andraszemes/one-lead-ecg/docs/kop-dokumentacia.pdf

Stredna priemyseln ´ | á skola elektrotechnick ˇ | a S. A. Jedlika v Nov ´ | ych Z ´ | amkoch ´

# Jednozvodovy elektrokardiograf ´

Praktická cas ˇ ť odbornej zlozky maturitnej sk ˇ | uśky ˇ
Nove Z´ amky, 2019 ´ | riesite ˇ

ľ: Andras Zemes ´
rocnˇ ík stˇ udia: ´ | stvrt ˇ | y´

konzultant: Mgr. Peter Hudec

Praktická cas ˇ ť odbornej zlozky maturitnej sk ˇ | uśky ˇ
a Zadanie ulohy pre komplexn ´ | u maturitn ´ | u sk ´ | uśku: ˇ
Meno a priezvisko: | Andras Zemes ´
Trieda: | 4. IT
Konzultant: | Mgr. Peter Hudec
Skolsk ˇ | y rok: ´ | 2018/2019
Odbor: | Informacnˇ e a sie ´ | ťove technol ´ | ogie ´
Nazov t ´ | emy: ´ | Jednozvodovy elektrokardiograf ´
Uloha: ´ | Zhotoviť prístroj, elektrokardiograf, na snímanie
a zachytenie elektrickych potenci ´ | alov srdca. ´
Prakticky charakter ´ | ulohy: ´ | Navrh plo ´ | snˇ eho spoja, programovanie ´
mikrokontrolera, vytvorenie grafickej aplik ´ | acie. ´
Andras Zemes, rie ´ | site ˇ

ľ

Mgr. Peter Hudec, interny konzultant ´

Zastupky ´ | na riadite ˇ

ľa skoly ˇ

V Novych Z ´ | amkoch d ´ | na 25.02.2019 ˇ

2

Ciastkov ˇ | é ulohy ´
1. Nastudovanie a spracovanie potrebnej te ˇ | orie ´
- Elektricky potenci ´ | al srdca ´
- Prehľad prístrojov EKG
- Signal a jeho spracovanie ´
2. Vytvorenie a konstrukcia pr ˇ | ístroja na meranie EKG
3. Vytvorenie elektronickej casti, pr ˇ | aca s mikrokontrol ´ | erom ´
4. Vytvorenie PC aplikacie na grafick ´ | e zobrazenie spracovan ´ | ych ´ | udajov ´
5. Webove rozhranie ku spracovan ´ | ym d ´ | atam ´

3

Cestn ˇ | e vyhl ´ | asenie ´
Ja, dolupodpísany Andr ´ | as Zemes, ´ | student 4. IT triedy Strednej priemyselnej ˇ | skoly S. A. Jedlika ˇ
v Novych Z ´ | amkoch, t ´ | ymto vyhlasujem, ´ | ze som t ˇ | uto pr ´ | acu vyhotovil s ´ | am, s pou ´ | zit ˇ ím uvedenej
literatury a pod ´

ľa rad m ´ ojho konzultanta. ˆ

Andras Zemes ´

4

## Podakovanie ˇ

Touto cestou by som sa chcel podakova ˇ | ť vsetk ˇ | ym, ktor ´ | í mi akymko ´

ľvek sposobom pomohli ˆ
a povzbudzovali ma pri vypracovaní mojej komplexnej maturitnej prace. Predov ´ | setk ˇ | ym v ´ | sak ˇ
patrí moja vdaka konzultantovi, Mgr. Petrovi Hudecovi, za jeho v ˇ | sestrann ˇ | u pomoc, za vedenie ´
a cenne pripomienky pri z ´ | avere ´ | cnom spracovan ˇ | í prace. ´

5

## Obsah

0 Uvod ´ | 7
1 Ciele | 8
2 Problematika a prehľad literatury | 9 ´
2.1 Elektrofyziologia srdca | | 9 ´
2.2 Akcnˇ y potenci ´ | al | | 10 ´
2.3.3 | Vydobytky modernej elektrokardiografie | | 12 ´
2.4 Umiestnenie elektrod | | 13 ´
2.5 Signal a jeho spracovanie | | 14 ´
2.5.1 | Sieťovy brum | | 14 ´
2.5.2 | Potlacenie driftu | | 14 ˇ
2.5.3 | Myopotencialy | | 14 ´
2.5.4 | Cˇíslicove filtre | | 15 ´
3 Metodika prace | 16 ´
3.1 Navrh a kon ´ | strukcia hardv ˇ | eru | | 16 ´
3.1.1 | Zosilnovac ˇ | í obvod na vyvojovej doske | | 16 ´
3.1.2 | Spajkovan ´ | y obvod | | 17 ´
3.1.3 | Finalny obvod a roz ´ | sirovacie moduly | | 18 ˇ
3.1.4 | Konstrukcia zariadenia | | 20 ˇ
3.2 Tvorba softveru | | 21 ´
3.2.1 | Hardverov ´ | e programovanie | | 21 ´
3.2.2 | Graficke pou ´ | zˇívateľske rozhranie (GUI) | | 21 ´
4 Vysledky a diskusia | 23 ´
5 Zavery pr ´ | ace | 27 ´
6 Zoznam pouzitej literat ˇ | ury | 28 ´
7 Prílohy | 29

6

## 0 Uvod ´

Ludsk ˇ | e telo je z ´ | azra ´ | cnˇ y´ ziv ˇ y organizmus, ktor ´ | y sa spr ´ | ava pod ´
ľa zakonitost ´ | í prírody a biologie. ´
Dnes znama podoba Homo sapiens je v ´ | ysledkom prirodzen ´ | eho evolu ´ | cnˇ eho v ´ | yberu, ktor ´ | ym´
prechadza u ´ | z mili ˇ | ony rokov. V ´ | daka nemu s ˇ | u na ´ | se org ˇ | any vyspel ´ | e a odoln ´ | e, dokonale sl ´ | uźia ˇ
prezitiu. Ich rola a presn ˇ | y sp ´ | osob fungovania v ˆ | sak dlho zost ˇ | avali z ´ | ahadou pred lek ´ | armi a ved- ´
cami v minulosti. Revolucnˇ e objavy a v ´ | ydobytky v medic ´ | íne viedli k podrobnemu zmapovaniu ´
a poznaniu ľudskeho tela, i ke ´ | d mnoho fenom ˇ | enov je doposia ´
| | | | | | | ľ nevysvetlenych. Choroby sa stali ´
liecite ˇ

ľnymi a pred ´

´lzil sa predpokladan ˇ | y vek do ´ | zitia. ˇ
V modernej dobe sa vyrazne zmenil ´ | stˇ yl, ak ´ | ym´ | zijeme. Jeho d ˇ | osledky nes ˆ | u na ´ | se tel ˇ | a, ktor ´ | é
neboli stavane na ru ´ | snˇ y, upon ´ | ah´
ľany sp ´ | osob ˆ | zivota a na zvl ˇ | adanie ka ´ | zdodenn ˇ | eho stresu. Ne- ´
spravna ´ | zivotospr ˇ | ava, zl ´ | e n ´ avyky a degrad ´ | acia ´ | zivotn ˇ | eho prostredia maj ´ | u z ´ aporn ´ | y vplyv na ´
zdravotny stav obyvate ´
ľstva a prispievaju k ´ | sˇíreniu civilizacnˇ ych ochoren ´ | í. Jedna sa o degen- ´
eratívne ochorenia, ktore patria medzi najp ´ | al´ civej ˇ | sie glob ˇ | alne zdravotn ´ | ícke problemy. ´
V rebríckoch naj ˇ | castej ˇ | sˇích prícin smrti sa ˇ | casto vyskytuj ˇ | u na prv ´ | ych prie ´ | ckach. ˇ
Skodliv ˇ | e zvyklosti ako nezdrav ´ | e stravovanie, nedostatok fyzickej aktivity, faj ´ | cenie a nad- ˇ
merna konzum ´ | acia alkoholu sa odzrkad ´
ľuju aj na srdci a obehovej s ´ | ustave. Tieto a mnoho ´
dal ˇ sˇích faktorov zvysuj ˇ u riziko srdcovocievnych ochoren ´ | í vratane k ´ | ornatenia tepien, infarktu ˆ
myokardu, vysokeho krvn ´ | eho tlaku, at ´ | d. ˇ Ludia si ve ˇ | ľakrat ani neuvedomuj ´ | u, ´ ze sa u nich vyv ˇ | íja
takato choroba, alebo si to uvedomia neskoro. ´
Riesenie m ˇ | oẑe poskytn ˇ | u´ť bioinformatika a biomedicínske inzinierstvo. S ˇ | u to vedn ´ | e dis- ´
ciplíny, ktore sa zaoberaj ´ | u zhroma ´ | zďovan ˇ | ím a vyhodnocovaním biologickych d ´ | at a kon ´ | strukciou ˇ
klinickych zariaden ´ | í. Vo veľkej miere uľahcuj ˇ u pr ´ | acu lek ´ | arom vo v ´ | casnom rozpoznan ˇ | í a liecbe ˇ
zdravotnych probl ´ | emov. Klasick ´ | ym pr ´ | íkladom biomedicínskeho prístroja je elektrokardiograf,
alebo skratkou EKG.
V roku 1903 Willem Einthoven zostrojil prvy funk ´ | cnˇ y elektrokardiograf. Pou ´ | zil strunov ˇ | y´
galvanometer na snímanie elektrickych potenci ´ | alov z kon ´ | cat ˇ ín pacienta. Jeho vynalez sa stal ´
zakladn ´ | ym kame ´ | nom elektrokardiografie, za ktor ˇ | y nesk ´ | or z ˆ | ískal Nobelovu cenu za fyziologiu ´
alebo medicínu. Vdaka Einthovenovi lek ˇ | ari dostali prv ´ | ykr ´ at v hist ´ | orii mo ´ | znos ˇ | ť nahliadnuť
hlboko do srdca a odhaliť skryte defekty prevodov ´ | eho syst ´ | emu. ´
Myslím si, ze najv ˇ | a¨cšˇím nepriateľom ľudstva je neinformovanosť. Pokiaľ chceme predísť
chorobam a ´ | ziˇ ť zdravy, plnohodnotn ´ | y´ zivot, mus ˇ | íme poznať moznˇ e n´ asledky rizikov ´ | eho spr ´ | avania. ´
Zamerom tejto pr ´ | ace je ´ | sˇíriť povedomie o dole ˆ zitosti starostlivosti o zdravie a preuk ˇ | aza ´ ť, ze po- ˇ
zorovanie vnutrotelov ´ | ych javov nemus ´ | í byť tak zlozit ˇ e ako sa na prv ´ | y poh ´
| | | | | | | | ľad zda.´

7

## 1 Ciele

Kľućˇ uspe ´ | snˇ eho elektrotechnick ´ | eho projektu spo ´ | cˇíva v dokonalej spolupraci jeho elektronick ´ | ych ´
a informacnˇ ych zlo ´ | ziek. Z ˇ | amerom tejto pr ´ | ace je pouk ´ | aza ´ ť na to, ze aj pomerne jednoduch ˇ | ymi ´
komponentmi sa daju vyrie ´ | siˇ ť komplexne probl ´ | emy. ´
Dole ˆ zit ˇ e aspekty v ´ | yslednej pr ´ | ace s ´ | u univerz ´ | alnos ´ | ť, portabilita a intuitívny dizajn. Prístroj by
mal dokaza ´ ť pouziˇ ť kazdˇ y bez ´ | speci ˇ | alneho vybavenia a bez podrobnej znalosti jeho fungovania. ´
Riesenie m ˇ | a by ´ | ť taktiez prenosn ˇ | e, aby bolo neobmedzene vyu ´ | zite ˇ

ľne.´
Pri navrhu plo ´ | snˇ eho spoja sa muselo prihliada ´ | ť i na bezpecnos ˇ | ť pri pouzit ˇ í prístroja. Elek-
trokardiograf sleduje pulz snímaním elektrickych potenci ´ | alov srdca z povrchu tela elektr ´ | odami. ´
Napajan ´ | ím obvodu bateriami a ochranou mal ´ | ym nap ´ | at¨ ím sa zabranilo v ´ | yskytu ne ´ | cakan ˇ | ych a ´
potencialne rizikov ´ | ych situ ´ | aci ´ í.
Pomocou jednozvodoveho EKG vieme ur ´ | ciˇ ť pulz, srdcovy rytmus, ba aj odhali ´ | ť prítomnosť
srdovych arytmi ´ | í a fibrilacie predsien ´ | í. Projekt moẑe taktie ˇ | z sl ˇ uźiˇ ť ako pomocka pri v ˆ | yú cbe elek- ˇ
troniky, programovania ci informatiky. Zn ˇ | azor ´ | nuje fungovanie sign ˇ | alov ´ | ych filtrov, opera ´ | cnˇ ych ´
zosilnova ˇ | cov, mikrokontrol ˇ | erov a grafick ´ | ych po ´ | cˇítacov ˇ ych aplik ´ | aci ´ í.

8

## 2 Problematika a prehľad literatury ´

Dovoľujem si vas obozn ´ | ami ´ | ť s teoretickymi v ´ | ychodiskami a informova ´ | ť o zakladn ´ | ych poz- ´
natkoch, ktore sa t ´ | ykaj ´ | u nastolenej problematiky. Princ ´ | ípy elektrokardiografie tvoria kmen tejto ˇ
prace a s ´ | u jej neoddelite ´

ľnou sućas ˇ ťou.

### 2.1 Elektrofyziologia srdca ´

Zakladom vn ´ | utorn ´ | eho fungovania srdca je jeho elektrick ´ | a aktivita. Srdce je jedine ´ | cnˇ y org ´ | an´
z hľadiska, ze jeho elektrick ˇ | á cinnos ˇ | ť nie je nervovo zalozen ˇ a. Vykon ´ | avaj ´ | u ju ´ | specializovan ˇ | é
vodive svalov ´ | e bunky. Zv ´ | azky tak ¨ | ychto buniek podmie ´ | nuj ˇ ú cerpaciu schopnos ˇ | ť srdca.
Svalove kontrakcie s ´ | u riaden ´ | e elektrick ´ | ymi impulzmi, ktor ´ | e sa ´ | sˇíria po prevodovom systeme ´
a pracovnom myokarde. Menia elektricke potenci ´ | aly na r ´ | oznych bodoch poko ˆ | zky pribli ˇ | zne ˇ
o tisícinu voltu (1 mV). Tato elektrick ´ | a aktivita skr ´ | yva v sebe neuverite ´
ľne mno ´ | zstvo inform ˇ | aci ´ í,
prostredníctvom ktorych z ´ | ískame nah´
ľad do fungovania tohto zazra ´ | cnˇ eho org ´ | anu. ´
Zdrojom tychto impulzov je sinoatri ´ | alny (SA) uzol, ktor ´ | y sa nach ´ | adza v stene hornej ´ | casti ˇ
pravej predsiene. Udava frekvenciu kontrakci ´ | í myokardu (srdcoveho svalstva), ktor ´ | a je nomin ´ | alne ´
70 tepov za minutu. ´
Signaly sa ´ | dalej ˇ | sˇíria vodivymi dr ´ | ahami predsien ´ | í a stimuluju svalov ´ | e kontrakcie. Pokra ´ | cuj ˇ ú
po srdcovej priehradke, septe, ktora odde ´

ľuje dve polovice srdca. Blízko bodu spojenia styroch ˇ
dutín srdca sa nachadza zhluk ´ | speci ˇ | alnych buniek - atrioventrikul ´ | arny (AV) uzol. Uzol AV ´
postup vzruchov mierne inhibuje a nasledne ich vysiela do Hisovho zv ´ | azku. ¨
Hisov zvazok sa del ¨ | í na dve vetvy, tzv. Tawarove ramienka. Obidve vetvy vedu do siete ´
Purkynov ˇ ych vl ´ | aken, ktor ´ | e aktivuj ´ | u pracovn ´ | y myokard. ´


Obrazok 1: Prevodov ´ | y syst ´ | em srdca ´

9

2.2 Akcnˇ y potenci ´ | al´
Ako vyraba a pren ´ | aśa srdcov ˇ | e tkanivo elektrick ´ | e impulzy? Aby sme si priebeh tohto deja mohli ´
vysvetliť, musíme sa preniesť az na ˇ | urove ´ | n at ˇ omov. ´
Atom je neutr ´ | alny, ´ | ak ma rovnak ´ | y po ´ | cet prot ˇ | onov (kladne nabit ´ | ych ´ | cast ˇ | íc) a elektronov ´
(zaporne nabit ´ | ych ´ | cast ˇ | íc).
Iony vznikaj ´ | ú z elektricky neutralnych at ´ | omov pridan ´ | ím resp. ubraním elektronov. ´
V pokoji je srdcova bunka v ´ | polarizovanom stave:
- mimobunkovy priestor je elektricky pozit ´ | ívny pre vysoku koncentr ´ | aciu kladn ´ | ych i ´ | onov ´
sodíka a vapnika ´
- vnutrobunkov ´ | y priestor je oproti vonkaj ´ | sej strane negat ˇ | ívny
- rozdiel potencialov je -90mV ´
Ked pokojov ˇ | y membr ´ | anov ´ | y potenci ´ | al dosiahne ur ´ | cit ˇ u prahov ´ | u hodnotu (cca. 15 mV), tzv. ´
akcnˇ y potenci ´ | al´ , tento pokojovy stav sa n ´ | ahle zmen ´ | í. V membrane bunky sa otvoria prieduchy ´
a kladne nabite i ´ ony pr ´ | udia sp ´ | a¨ť do bunky. Tato n ´ | ahla strata polariz ´ | acie sa vol ´ | a depolariz ´ | acia ´
a vznika pri nej elektrick ´ | y pr ´ | ud. ´
Po depolarizacii nast ´ | ava protikladn ´ | y dej, repolariz ´ | acia, ke ´ | d sa i ˇ | ony znovu pre ´ | cerp ˇ | avaj ´ | u von ´
mimo membranu. Depolariza ´ | cnˇ a vlna vyvol ´ | avan ´ | a uzlom SA sa ´ | sˇíri po prevodovom systeme ´
srdca a uvadza svaly do pohybu. Proces, ktor ´ | y za ´ | cal pumpovan ˇ | ím ionov takto kon ´ | cˇí pumpo-
vaním krvi.

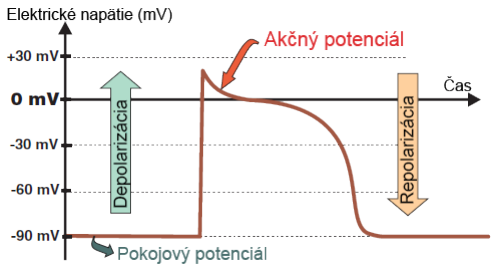
[picture p19: figure]

Obrazok 2: Ak ´ | cnˇ y potenci ´ | al v grafickom vyobrazen ´ | í

10

### 2.3 Prehľad prístrojov EKG

2.3.1 Druhy funkcnˇ ych vy ´ | setren ˇ | í
Elektrokardiografia je jednym zo z ´ | akladn ´ | ych lek ´ | arskych vy ´ | setren ˇ | í. Najcastej ˇ | sie sa vyu ˇ | zˇíva
v nudzov ´ | ych situ ´ | aci ´ ach pri podozren ´ | í na srdcovy infarkt, na zistenie poruchy s ´ | uvisiacej s kar- ´
diovaskularnym syst ´ | emom alebo ako prevent ´ | ívne vysetrenie so z ˇ | amerom odhali ´ | ť moznˇ y srdcov ´ | y´
defekt.
Vysetrenie EKG je neinvaz ˇ | ívne a nevyzaduje ˇ | ziadnu ˇ | speci ˇ | alnu pr ´ | ípravu. Pri klasickom EKG
sa elektrody pripevnia na hrudn ´ | ík, zap´ astia a ¨ | clenky pacienta. Elektrick ˇ | e sign ´ | aly zachyten ´ | é
z povrchu tela, ktore s ´ u spravidla ve ´
ľmi slabe, v r ´ | adoch milivoltov, pr ´ | ístroj zosilní a zaznamena.´
Nasledne ich lek ´ | ar vyhodnot ´ | í.
Existuje niekoľko roznych druhov vy ˆ | setrn ˇ | í:
Standardn ˇ | e 12-zvodov ´ | e EKG ´
Je najcastej ˇ | sie pou ˇ | zˇívany zo v ´ | setk ˇ | ych typov EKG. Pozost ´ | ava zo 6 kon ´ | catinov ˇ | ych zvodov a 6 ´
hrudnych zvodov. Ka ´ | zdˇ y zvod je samostatne zapisovan ´ | y na priebe ´ | zne sa posunuj ˇ | uci ´ | speci ˇ | alny ´
zaznamov ´ | y papier, pr ´ | ípadne zobrazuje hodnoty na monitore.

Za´ťazov ˇ e EKG (ergometria) ´

Ukaźe spr ˇ | avanie srdca a obehov ´ | eho syst ´ | emu pri n ´ | amahovej aktivite. Na simul ´ | aciu sa v ´ | a¨cšinou ˇ
pouzˇíva stacionarny bicykel alebo be ´ | zeck ˇ | y p ´ as. Monitoruje sa z ´ | aznam EKG v s ´ | uvislosti ´
s krvnym tlakom. Na z ´ | azname sa p ´ | atra po zmen ´ | ach, ktor ´ | e na EKG urobenom v pokoji nie ´
su vidite ´

ľne.´

Dynamicke EKG ´

Umozňuje sledova ˇ | ť srdcovú cinnos ˇ | ť pri beznˇ ych aktivit ´ | ach po ´ | cas 12-48 hod ˇ | ín. Zvyśen ˇ ím doby
monitorovania sa zvysuje pravdepodobnos ˇ | ť nalezu nepravidelnost ´ | í rytmu alebo namahov ´ | ych ´
ischemi ´ | í myokardu v zazname. ´

Tlakovy Holter ´

Ambulantne 24-hodinov ´ | e sledovanie krvn ´ | eho tlaku je jednoduch ´ | e vy ´ | setrenie ˇ | casto indikovan ˇ | é
pri diagnostikovaní hypertenzie. Sníma sa tlak krvi v domacom prostred ´ | í pri kazdodenn ˇ | ych ´
cinnostiach pomocou nafukovacej man ˇ | zety. ˇ
EKG urcuje z ˇ | akladn ´ | e fyziologick ´ | e hodnoty ako s ´ | u frekvencia srdcovej ´ | cinnosti, rytmus, elek- ˇ
tricka os srdca, prevodov ´ | é casy a morfol ˇ | ogia segmentov EKG krivky. Na z ´ | aklade t ´ | ychto para- ´
metrov moẑe by ˇ | ť stanovena diagn ´ | oza a rozpoznan ´ | a porucha srdcov ´ | eho rytmu (arytmia), porucha ´
prevodu elektrickych vzruchov, ischemick ´ | a choroba srdca a in ´ | e patologick ´ | e zmeny v myokarde. ´

11

2.3.2 Casti klasick ˇ | eho pr ´ | ístroja EKG
Tepelna tla ´ | cov ˇ a hlava ´
Kreslí EKG krivku generovaním tepla.

Termopapier
Prichadza do kontaktu s tla ´ | covou hlavou. Na mieste dotyku sa farba papiera men ˇ | í na ciernu, ˇ
takto vznika krivka EKG. Papier je tie ´ | z citliv ˇ | y na tlak. ´

Elektrody ´
Elektrody s ´ | u vyroben ´ | e z vodiv ´ | eho materi ´ | alu, ktor ´ | y dok ´ | aźe zachyti ˇ | ť elektricke impulzy zo srdca. ´
Signaly odosielaj ´ | u na spracovanie do meracieho pr ´ | ístroja cez pripojene k ´ able. ´
Zosilnova ˇ | cˇ
Zosilnova ˇ | c je zariadenie, ktor ˇ | e sa nach ´ | adza v elektrokardiografe a zvy ´ | suje amplit ˇ | udu elek- ´
trickeho sign ´ | alu. Sign ´ | aly prich ´ | adzaj ´ | uce zo srdca s ´ | u relat ´ | ívne slabe (0,0001V a ´ | z 0,003V) a je ˇ
potrebne ich zosilni ´ | ť.

Galvanometer
Premiena pr ˇ | ud na mechanick ´ | y pohyb. ´

Sada EKG kablov ´
Sluźia na spojenie zvy ˇ | cajne desiatich elektr ˇ | od s hlavnou jednotkou pr ´ | ístroja EKG. Takato kon- ´
figuracia umo ´ | zňuje monitorova ˇ | ť srdce z 12 ,,pohľadov”.

### 2.3.3 Vydobytky modernej elektrokardiografie ´

Moderne pr ´ | ístroje EKG disponuju zabudovan ´ | ymi mikroprocesormi, ktor ´ | e ich riadia a roz ´ | siruj ˇ | ú
ich diagnosticke schopnosti. V ´ | daka sofistikovan ˇ | ym matematick ´ | ym algoritmom a modelom s ´ | ú
schopne previes ´ | ť zlozit ˇ u anal ´ | yzu sign ´ | alu a automaticky ho vyhodnoti ´ | ť. Su kompaktn ´ | e, prenosn ´ | é
a vhodne i na monitorovanie mimo zdravotn ´ | íckeho zariadenia.
Prepojiteľnosť s pocˇítacom je v dne ˇ | snej dobe takmer samozrejmos ˇ | ťou, niektore dokonca ko- ´
munikuju bezdr ´ | otovo a aj na dia ˆ
ľku. Digitalizacia ´ | udajov m ´ | oẑe by ˇ | ť vyhodn ´ | a napr ´ | íklad z hľadiska
archivacie alebo v pr ´ | ípade potreby zdieľať zaznam so ´ | specialistom. ˇ
Kardiologicky monitor je ´ | cast ˇ | ym roz ´ | sˇírením zariadenia EKG a umozňuje dlhodobo sledova ˇ | ť
srdcovu aktivitu pacienta. ´ | Udaje zobrazuje v re ´ | alnom ´ | case a pon ˇ | uka n ´ | ah´

ľad kriviek este pred ich ˇ zapisom na papier. ´

12

### 2.4 Umiestnenie elektrod´

Tri koncatinov ˇ | e elektr ´ | ody (prav ´ | a ruka, ´

ľava ruka, ´

ľava noha) vytv ´ | araj ´ | u Einthovenov trojuholn ´ | ík.
Vzniknu 3 ´ | bipolarne zvody ´ | reprezentovane stranami trojuholn ´ | íka. Kazdˇ y zvod pozost ´ | ava ´
z dvoch elektrod, z pozit ´ | ívneho a z negatívneho. Pozitívny a negatívny pol spolu tvoria elek- ´
tricky vektor, ktor ´ | y sa premieta na papier. ´
Zvod I: | VI = φL −φR

Zvod II: VII = φF −φR

Zvod III: VIII = φF −φL

, kde:
VI = napatie zvodu I ¨
VII = napatie zvodu II ¨
VIII = napatie zvodu III ¨
φL = potencial na ´

ľavej ruke
φR = potencial na pravej ruke ´
φF = potencial na ´

ľavej nohe

Podľa Kirchhoffovho zakona plat ´ | í, ze ve ˇ
ľkosť potencialov (amplit ´ | ud na EKG z ´ | azname) vo zvode ´
VII je sumou potencialov v zvodoch ´ | | VI a VIII:
VI +VIII = VII , z coho vypl ˇ | yva, ´ | ze iba dva z troch zvodov s ˇ | u nez ´ | avisl ´ | e.´
Einthoven definoval rozdiely potencialov medzi troma p ´ | armi horeuveden ´ | ych bodov ako z ´ | akladn ´ | é
koncatinov ˇ | e zvody v elektrokardiografii. ´


Obrazok 3: Einthovenove kon ´ | catinov ˇ | e zvody a Einthovenov trojuholn ´ | ík

13

### 2.5 Signal a jeho spracovanie ´

Po uspe ´ | snom zmeran ˇ | í a zosilnení signalu ´ | cel ˇ íme zlozitej prek ˇ | aźke v snahe zachyti ˇ | ť srdcovy´
rytmus. Signal je s ´ | íce zosilneny, ale na ´ | dalej obsahuje mnoho ne ˇ | ziaducich elementov vplyvom ˇ
rusivˇ ych faktorov z okolia. V ´ | ysledkom je skreslen ´ | y biosign ´ | al, ktor ´ | y je v tejto f ´ | aze nepou ´ | zite ˇ

ľny.´
Nepresnosti v meraniach odborne nazyvame ´ | artefakty. | Artefakty sa moẑu prejavova ˇ | ť
v mensej ˇ | ci v ˇ | a¨cšej miere v z ˇ | avislosti od nedokonalost ´ | í v priebehu vedenia signalu z pacienta ´
do aparatury (pr ´ | ístroja). V elektrokardiografii rozoznavame tri z ´ | akladn ´ | e druhy artefaktov: ´
- sieťovy brum ´
- kolísanie nulovej línie (drift)
- myopotencialy ´
V minimalizacii ne ´ | ziaduceho ˇ | sumu n ˇ | am napom ´ | aha s ´ | ubor ´ | specializovan ˇ | ych hardv ´ | erov ´ | ych ´
i digitalnych filtrov. ´

### 2.5.1 Sieťovy brum ´

Prvym krokom spracovania sign ´ | alu je z ´ | akladn ´ | a hardv ´ | erov ´ | a filtr ´ | acia. Elektromagnetick ´ | a inter- ´
ferencia (EMI) vznika p ´ osoben ˆ | ím elektromagnetickeho po ´

ľa z elektrickej siete. Pri tomto jave
dochadza k vzniku indukovan ´ | eho nap ´ | atia (Ui) a indukovan ¨ | eho pr ´ | udu na vodi ´ | ci. ˇ Sum op ˇ | ísaneho ´
druhu moẑeme charakterizova ˇ | ť pri frekvencii 50 Hz sínusoveho ru ´ | senia. Na potla ˇ | cenie sie ˇ | ťoveho ´
brumu je ućinn ˇ | a kombin ´ | acia hardv ´ | erov ´ | eho RC ´ | clˇ anku s digit ´ | alnym filtrom. ´

### 2.5.2 Potlacenie driftu ˇ

Drift alebo kolísanie nulovej línie opisuje skupinu elektrochemickych a mechanick ´ | ych javov. ´
Príkladmi elektrochemickych s ´ | u potenie pod elektr ´ | odami, nedostato ´ | cnˇ e odmastenie poko ´ | zky, ˇ
male mno ´ | zstvo kontaktn ˇ | eho g ´ | elu. D ´ | ychanie (do 0,8 Hz) a pomal ´ | e pohyby klienta (do 2 Hz) s ´ | ú
mechanicke javy. Na odstr ´ | anenie n ´ | ízkofrekvencnej ru ˇ | sivej zlo ˇ | zky pou ˇ | zijeme hornopriepustn ˇ | y´
filter.

### 2.5.3 Myopotencialy ´

Dal ˇ sˇí rusivˇ y faktor pri vy ´ | setren ˇ | í EKG predstavuje svalova aktivita, najm ´ | a pri z ¨ | a´ťazovom EKG. ˇ
Svaly pocas pohybu vytv ˇ | araj ´ | u elektrick ´ | e impulzy, ktor ´ | e sa potom prejavuj ´ | u vo forme musku- ´
loskeletalneho artefaktu. Najv ´ | a¨cšˇím problemom v zdolan ´ | í ućinku myopotenci ˇ | alov je vz ´ | ajomn ´ | é
prekryvanie frekven ´ | cnˇ eho p ´ | asma svalovej aktivity a u ´ | zito ˇ | cnˇ eho p ´ | asma EKG. Na odstr ´ | anenie ´
tohto artefaktu nie je ućinn ˇ | a p ´ asmov ´ | a priepus ´ | ť. Vyzaduje sa pokro ˇ | cilej ˇ | sie rie ˇ | senie, napr ˇ | íklad
pomocou adaptívnej filtracie. ´

14

### 2.5.4 Cˇ íslicove filtre ´

Konecnˇ a impulzn ´ | a odozva - FIR ´
,,Filtre s konecnou impulznou charakteristikou (FIR – Finite Impulse Response) s ˇ | | | | | u filtrami ´
matematicky jednoduchsie op ˇ | ísateľnymi ako IIR filtre, preto ´ | ze s ˇ | u v ´ a¨cšinou realizovan ˇ | e nerekur- ´
zívne (nemaju sp ´ | atn ¨ u v ´ azbu). Pri nerekurz ¨ | ívnej realizaci ´ í ma filter v ´ | setky p ˇ | oly v po ´ | ciatku, ˇ | coˇ
mu zarucuje stabilitu. Medzi z ˇ | akladn ´ | e vlastnosti FIR filtrov je okrem stability aj mo ´ | znos ˇ | ť získať
linearnu f ´ | azov ´ | u kmito ´ | ctov ˇ | u charakteristiku v celom kmito ´ | ctovom rozsahu.” ˇ

(Tuka, 2015)


Obrazok 4: Blokov ´ | a sch ´ | ema FIR filtra ´
Nekonecnˇ a impulzn ´ | a odozva - IIR ´

,,Filtre s nekonecnou impulznou charakteristikou (IIR – Infinite Impulse Response) vznikli ako ˇ
cˇíslicove varianty anal ´ | ogov ´ | ych filtrov. S ´ | u matematicky zlo ´ | zitej ˇ | sie ako FIR filtre, preto ˇ | ze s ˇ | ú
realizovanerekurz ´ | ívne (vzdy obsahuj ˇ | u sp ´ | atn ¨ u v ´ azbu). Oproti FIR filtrom v ¨ | sak nie je treba tak ˇ
veľky po ´ | cet oneskorovac ˇ | ích clenov a preto je mo ˇ | znˇ e ho pou ´ | ziˇ ť aj na kratsie d ˇ | ata (inicializ ´ | acia ´
nie je tak dlha). IIR filtre maj ´ | u v ´ seobecne v ˇ | a¨cšˇí pocet zapojen ˇ | í ako FIR prave pre ich rekurz ´ | ívnu
cas ˇ ť.”

(Tuka, 2015)


Obrazok 5: Blokov ´ | a sch ´ | ema IIR filtra ´

15

## 3 Metodika prace ´

3.1 Navrh a kon ´ | strukcia hardv ˇ | eru ´
Proces navrhu hardv ´ | erov ´ | ych komponentov som si rozdelil do nieko ´
ľkych f ´ | az kv ´ | oli systematic- ˆ
kosti. Takyto sp ´ | osob pr ˆ | ace mi umo ´ | znil priebe ˇ | znˇ e testovanie a odha ´
ľovanie moznˇ ych ch ´ | yb po ´ | cas ˇ
vyvoja. Od za ´ | ciatku a ˇ | z po fin ˇ | alny dizajn som pre ´ | siel tromi iter ˇ | aciami projektu. ´
Na navrh elektroniky a dizajn plo ´ | snˇ ych spojov som pou ´ | zˇíval graficky po ´ | cˇítacov ˇ y editor ´
Eagle (verzia 9.1.3).
3.1.1 Zosilnovac ˇ | í obvod na vyvojovej doske ´
Prvy prototyp obvodu bol vyroben ´ | y pod ´
ľa jednoduchej schemy. Pozost ´ | avala iba z jedn ´ | eho ´
operacnˇ eho zosil ´ | nova ˇ | ca a zop ˇ | ar rezistorov. Z bezpe ´ | cnostn ˇ | ych d ´ | ovodov bola namiesto labo- ˆ
ratorneho zdroja pou ´ | zit ˇ a 9V bat ´ | eria na nap ´ | ajanie obvodu. ´
Operacnˇ y zosil ´ | nova ˇ | c LM741 sl ˇ | uźi na zosilnenie n ˇ | ízkonapa¨ťoveho vstupu z elektr ´ | od prilo ´ | ze- ˇ
nych na povrch tela. Je zapojen ´ | y v diferen ´ | cnej konfigur ˇ | aci ´ í, jeho invertujuci a neinvertuj ´ | uci ´
vstup predstavuju rozdielne nap ´ | atia. V ¨ | ystup je teda funkciou nap ´ | a¨ťovej diferencie medzi dvoma
hrudnymi elektr ´ | odami. Faktor zisku je pribli ´ | zne 50 pod ˇ
ľa pomeru R5:R4. Z dovodu, ˆ | ze zosil ˇ | nova ˇ | cˇ
funguje optimalne pre stredov ´ | e hodnoty (medzi maximom a minimom), je nutn ´ | e jeho vstupy ´
dostať do pouzite ˇ
ľneho p ´ | asma. Na tento ´ | ućel sl ˇ | uźi nap ˇ | a¨ťovy deli ´ | c R1-R2. ˇ
Analogov ´ | y v´ ystup bol pripojen ´ | y do 3,5 mm mikrof ´ | onov ´ | eho rozhrania zvukovej karty po ´ | cˇítaca. ˇ
Signal pre ´ | siel z ˇ | akladnou softv ´ | erovou filtr ´ | aciou a bol graficky zobrazovan ´ | y pomocou po ´ | cˇítacovej ˇ
aplikacie. ´
Hlavnou problematikou tohto navrhu bola v ´ | seobecn ˇ | a nespo ´

ľahlivosť a vyskyt elektromag- ´
netickej interferencie a inych artefaktov v meran ´ | ych hodnot ´ | ach. ´


Obrazok 6: Sch ´ | ema zosil ´ | novacieho obvodu ˇ

16

3.1.2 Spajkovan ´ | y obvod ´

Dal ˇ sˇím krokom bolo navrhnu´ť plosnˇ y spoj v Eagli pod ´

ľa vysšej uvedenej sch ˇ | emy zosil ´ | novacieho ˇ
obvodu. Na zaklade po ´ | cˇítacov ˇ eho n ´ | avrhu bol zhotoven ´ | y druh ´ | y prototyp na sp ´ | ajkovate ´

ľnej
vyvojovej doske. Elektrick ´ | e s ´ ućiastky boli osaden ˇ | e a posp ´ | ajan ´ | e vodiv ´ | ymi cestami z c ´ | ínu. Doska
mala celkovo 6 vyvodov: ´
- VCC (+5V) napajanie ´
- GND - zem
- OUT - analogov ´ | y v ´ ystup ´
- Hrudny zvod ´ | c. 1 ˇ
- Hrudny zvod ´ | c. 2 ˇ
- Prava noha ´
Signal bol meran ´ | y a sprac ´ | uvan ´ | y za pomoci Arduina UNO. V ´ | ystup zo zosil ´ | nova ˇ | ca bol spojen ˇ | y´
s analogov ´ | ym pinom Arduina A0 (ADC). Vykres ´

ľovanie krivky EKG sa zrealizoval zabudova-
nym n ´ | astrojom programu Arduino IDE, ktor ´ | y sa naz ´ | yva Serial Plotter. ´
Zobrazovany sign ´ | al bol do ve ´
ľkej miery znecisten ˇ | y, preto bolo nutn ´ | e pou ´ | ziˇ ť softverov ´ | y filter. ´
Najjednoduchsˇí filter vhodny na ´ | ulohu bol s ´ | ućas ˇ ťou oficialnej kni ´ | znice Filters.h. ˇ
| | | | | | 1
Nasledovny k ´ od je implement ´ | aciou dolnopripustn ´ | eho filtra RC, ktor ´ | y sl ´ | uźi na vyhladenie ˇ
signalu. Filter je nastaven ´ | y na frekvenciu 50 Hz. Obsahuje deklar ´ | aciu premenn ´ | ych a ini- ´
cializaciu triedy FilterOnePole. ´

f l o a t f i l t e r F r e q u e n c y = 5 . 0 ;

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

w hil e ( t r u e ) {
l o w p a s s F i l t e r . i n p u t ( a n al o gR e a d ( INPUT PIN ) ) ;
}
Filter funguje na baze nekone ´ | cnej impulznej odozvy (IIR). Hlavnou v ˇ | yhodou je, ´ | ze rie ˇ | senie ˇ
kladie veľmi nízke naroky na pam ´ | a¨ť a vypo ´ | ctov ˇ | u kapacitu. Ve ´
ľke pozit ´ | ívum znamena tak- ´
tiez jednoduchos ˇ | ť implementacie do projektu. Onedlho sa v ´ | sak prejavili seri ˇ | ozne probl ´ | emy ´
sposoben ˆ | e vlastnos ´ | ťami spomínaneho filtra. Po ´ | uvodnom zachyten ´ | í impulzov amplituda pos- ´
tupne klesala, az k ˇ ym nedosiahla nulu. Tak ´ | eto spr ´ | avanie je nepriazniv ´ | ym ved ´
| | | | | | ľajsˇím ućinkom ˇ
IIR filtrov.
1Dokumentacia k spom ´ | ínanej kniznici je dostupn ˇ | a na webovom s ´ | ídle playground.arduino.cc/Code/Filters

17

3.1.3 Finalny obvod a roz ´ | sirovacie moduly ˇ
Vysledn ´ | y produkt zah ´ | ´rna nieko ˇ
ľko dole ˆ zit ˇ ych komponentov. ´ | Ustredn ´ | ú cas ˇ ť strukt ˇ | ury zariadenia ´
tvorí osobitne navrhnuty a na mieru vyroben ´ | y plo ´ | snˇ y spoj. T ´ | ato doska priamo sp ´ | aja anal ´ | ogov ´ | ú
cas ˇ ť aplikacie dovedna s digit ´ | alnym sign ´ | alov ´ | ym procesorom. ´ | Dalej je doplnen ˇ | a o dva roz ´ | sirovacie ˇ
moduly a baterie. ´

Mikroprocesor

Mikroprocesor je centralnym prvkom zariadenia. Zodpoved ´ | a za digitaliz ´ | aciu a sprac ´ | uvanie ´
príchodzieho signalu, riadenie a koordin ´ | aciu jednotliv ´ | ych elektrick ´ | ych ´ | clˇ ankov v r ´ | amci aplik ´ | acie ´
a odovzdavaie inform ´ | acii po ´ | cˇítacu. ˇ
Pri vybere mikroprocesora sa prihliadalo na v ´ | ykon, ´ | uspornos ´ | ť, pocet v ˇ | yvodov a na ve ´

ľkosť
dostupnej programovej pamate. Nakoniec sa uprednostnil 8-bitov ¨ | y mikroradi ´ | c Atmega328P ˇ
z rodiny megaAVR od firmy Atmel. Vyhovel vsetk ˇ | ym po ´ | ziadavk ˇ | am projektu, je vhodn ´ | y na ´
ulohu DSP a disponuje kvalitnou dokument ´ | aciou i komunitnou podporou zo strany v ´ | yvoj ´ | arov. ´
Podrobnosti o mikroprocesore su op ´ | ísane v tabu ´

ľke nizšie. ˇ
2
Parameter | Hodnota
Typ programovej pamate | Flash ¨
Veľkosť programovej pamate (KB) 32 ¨
Max. rychlos ´ | ť CPU (MIPS) | 20
Komunikacnˇ e perif ´ | erie | 1-UART, 2-SPI, 1-I2C ´
Tepelna tolerancia (C) | -40 do 85 ´
Napajacie nap ´ | atie (V) | 1,8 do 5,5 ¨
Pocet v ˇ | yvodov | 28 ´

Tabuľka 1: Parametre mikroprocesora

Napaľovanie zavadza ´ | caˇ
Zavadza ´ | c (angl. bootloader) mikroprocesora je prv ˇ | y program, ktor ´ | y sa spust ´ | í pri kazdom ˇ | starte. ˇ
Asistuje pri nahravan ´ | í kodu do flash pam ´ | ate a ¨ | cip sa st ˇ | ava samoprogramovac ´ | ím, cˇím zaniká
potreba programatora. ´
Samostatny´ cip Atmega328P sa dod ˇ | ava bez zav ´ | adza ´ | ca, t ˇ | ym p ´ | adom sa priamo ned ´ | a pro- ´
gramovať. Proces napaľovania bootloadera riadi medziclˇ anok zvan ´ | y in-system program (ISP). ´
Na tuto rolu vyhovuje aj doska Arduino UNO. ´
Prvym krokom je nahra ´ | ť sabl ˇ | onu ArduinoISP na dosku. Potom sa prepoj ´ | í mikrocip s Ar- ˇ
duinom podľa specifickej sch ˇ | emy zapojenia. V nastaveniach sa zvol ´ | í typ dosky ,,Arduino Duemi-
lanove alebo Nano” pre 16 MHz konfiguraciu. Za program ´ | ator sa vyberie mo ´ | znos ˇ | ť ,,Arduino as
ISP”.
Po dokladnej kontrole v ˆ | setk ˇ | ych nastaven ´ | í sa moẑe spusti ˇ | ť nahravanie zav ´ | adza ´ | ca (Tools ˇ | →
Burn Bootloader).

2
Informacie boli ´ | cerpan ˇ | e zo str ´ | anky v ´ | yrobcu ´ | www.microchip.com/wwwproducts/en/ATmega328p
| | | 18

FT232RL programator s Mini USB ´

Adapter USB–serial zabezpe ´ | cuje programovanie ˇ | cipov a komunik ˇ | aciu s nimi. Komunik ´ | acia ´
prebieha cez UART, tj. cez Rx a Tx piny. Uspe ´ | snˇ e nahratie programu m ´ | a jednu podmienku: na ´
cipe sa mus ˇ | í nachadza ´ | ť zavadza ´ | c. Modul je kompatibiln ˇ | y s nap ´ | atiami 3.3V a taktie ¨ | z 5V, ladenie ˇ
sa umozňuje pomocou prep ˇ | ínaca. Zapojenie mus ˇ | í byť doplnene o kondenz ´ | ator (0 ´ | .1 µF) a o pull
up rezistor na vyvode DTR, aby resetovanie mohlo spr ´ | avne prebehn ´ | u´ť.
FT232RL | Atmega328
DTR | RESET
TXD | RX
RXD | TX
5V | VCC
CTS (clear to send) patrí do standardu FT232, nie je nutn ˇ | e ho pou ´ | ziˇ ť
GND | GND

Tabuľka 2: Definície pinov

Slot pre Micro SD kartu

Slot umozňuje ˇ | cˇítanie a zapisovanie udajov na Micro SD kartu. Prenos ´ | udajov sa uskuto ´ | cňuje ˇ
cez standardn ˇ | e SPI rozhranie. Modul funguje s logick ´ | ym nap ´ | at¨ ím 3.3V, avsak v ˇ | daka zabu- ˇ
dovaneho regul ´ | atora toleruje aj 5V. T ´ | ym p ´ | adom je plne kompatibiln ´ | y so v ´ | setk ˇ | ymi Arduino ´
doskami a s príslusnou nat ˇ | ívnou kniznicou ˇ | SD.h z ponuky Arduino IDE.
Vyroba integrovan ´ | eho plo ´ | snˇ eho spoja ´
Hotovy digit ´ | alny n ´ | avrh skompletizovan ´ | eho plo ´ | snˇ eho spoja bol odoslan ´ | y do v ´ | yroby profesion ´ | al- ´
nemu vyrobcovi. K objedn ´ | avke bol prilo ´ | zen ˇ y s ´ ubor ´ | .brd vyexportovany z projektu Eagle (vi ´ | d.ˇ
prílohu). Specifik ˇ | acie objednanej dosky: ´
Jednostranny plo ´ | snˇ y spoj so sp ´ | ajkovate ´
ľnym ochrann ´ | ym lakom ´
Hrubka dosky a medenej vrstvy: ´ | 1.5 mm, 35 µm
Rozmery PCB: 65x50 mm
Pocet otvorov: ˇ | | 87 ks
Po dorucen ˇ í objednanej dosky nasledovalo manualne osadenie s ´ | ućiastok. Ako prv ˇ | e boli ´
prispajkovan ´ | e p ´ atice integrovan ¨ | ych obvodov: DIP28 pre mikroprocesor a DIP8 pre opera ´ | cnˇ y´
zosilnova ˇ | c. Pou ˇ | zitie p ˇ | at¨ íc sa odporuća v pr ˇ | ípade citlivych komponentov z d ´ | ovodu, aby sa ˆ
predislo ich mo ˇ | znˇ emu po ´ | skodeniu pri vysok ˇ | ych teplot ´ | ach po ´ | cas sp ˇ | ajkovania. ´
Dalej boli postupne osaden ˇ | e ostatn ´ | e s´ ućiastky ako kry ˇ | stˇ al 16 MHz, cievka, rezistory a keram- ´
icke kondenz ´ | atory. Pri osadzovan ´ | í bipolarnych s ´ | ućiastok (napr. sveteln ˇ | e di ´ | ody, elektrolytick ´ | é
kondenzatory) sa nesmie zab ´ | uda ´ ť na spravne smerovanie kladn ´ | ych, resp. z ´ | aporn ´ | ych p ´ | olov. ´
Naposledy boli prispajkovan ´ | e nap ´ | ajacie a vstupnov ´ | ystupn ´ | e piny pre roz ´ | sirovacie moduly ˇ
a elektrodov ´ | e vodi ´ | ce. ˇ
| | | | 19

### 3.1.4 Konstrukcia zariadenia ˇ

Poslednym krokom v pr ´ | aci s hradv ´ | erom bolo umiestni ´ | ť vsetk ˇ | y komponenty do ´ | skatu ˇ

ľky. Na
tento ućel padla vo ˇ

ľba na univerzalny kryt HM-1553DGY ´ 3 od Hammmondu s rozmermi
89x147x24 mm v tmavosivom prevedení. Vyrobn ´ | y materi ´ | al je plast ABS. Kryt sa sklad ´ | á
z troch cast ˇ | í: z predneho panelu a z vrchnej a spodnej ´ | casti, ktor ˇ | e sa uzatv ´ | araj ´ | ú styrmi skrutkami. ˇ
Napajacie puzdro na tri AA bat ´ | erie bolo ulo ´ | zen ˇ e pozd ´
´lzne v zadnej ˇ | casti krytu. K nemu bol ˇ
pripevneny zvisle polohovan ´ | y USB—Serial modul. Na zadnej stene bol taktie ´ | z vytvoren ˇ | y otvor ´
na rozhranie Micro USB.
Okraje hlavneho plo ´ | snˇ eho spoja boli upraven ´ | e a tvarovan ´ | e tak, aby sa doska mohla prichyti ´ | ť
o jeden z podpornych st ´
´lpikov. Nasledne bola vyv ´ | ´rtana diera pre sveteln ´ | u indika ´ | cnˇ u di ´ | odu ´
a vytvoreny obd ´
´lznikov ˇ | y otvor pre vyp ´ | ínac. Na prednom paneli boli vyv ˇ | ´rtane diery s v ´ | a¨cšˇím
priemerom na vsadenie troch laboratornych konektorov. ´
Nakoniec boli vsetky komponenty upevnen ˇ | e obojstrannou lepiacou p ´ | askou. Roz ´ | sirovacie ˇ
moduly, vypínac a konektory boli zapojen ˇ | e do riadiacej dosky ´ | ci u ˇ z priamo alebo prepojovac ˇ | ími
kablami. Prepojovacie k ´ | able museli by ´ | ť vyrobene na mieru kv ´ | oli nev ˆ | sedn ˇ | ym po ´ | ziadavk ˇ | am na ´
d´lzku a po ˇ | cet vodi ˇ | cov a tvar pr ˇ | ípojky.

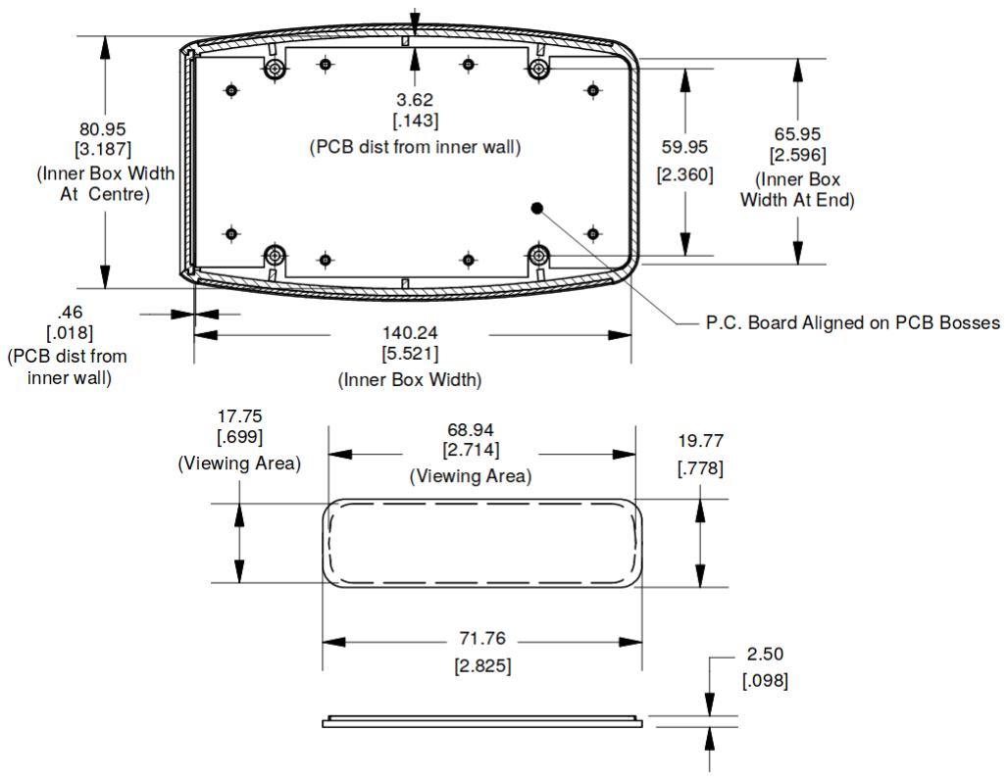
[picture p20: figure]

Obrazok 7: N ´ | arys a p ´ | odorys ˆ | skatu ˇ

ľky s rozmermi

3Technicky v ´ ykres krytu so ´ | specifik ˇ | aciami a rozmermi sa nach ´ | adza na str ´ | anke distrib ´ | utora ´
https://www.tme.eu/sk/Document/bd6787db93f837d8972974413558d5cd/HM-1553DBK.pdf

20

### 3.2 Tvorba softveru ´

Softverov ´ | a zlo ´ | zka tvor ˇ | í druhu nav ´ | yznamnej ´ | siu ˇ | cas ˇ ť tejto prace. Z h ´

ľadiska spracuvania, zobra- ´
zovania, vyhodnocovania a eventualnej pou ´ | zite ˇ
ľnosti signalu zohr ´ | avaj ´ | u programov ´ | e prostriedky ´
dole ˆ zit ˇ u a nenahradite ´
ľnú ulohu. V ´ | yvoj softv ´ | eru predstavoval komplexn ´ | y proces, ktor ´ | y zah ´ | ´rnal ˇ
zuzitkovanie mo ˇ | znost ˇ | í roznych programovac ˆ | ích jazykov a prostredí.
Kazdˇ y stupe ´ | n pr ˇ | ace so sign ´ | alom m ´ | a za ´ | ulohu rie ´ | siˇ ť samostatny probl ´ | em a z ´ | arove ´ | n komu- ˇ
nikovať s ostatnymi jednotkami. Aplika ´ | cnˇ a vrstva projektu sa del ´ | í na tri hlavné casti: ˇ
1. Hardverov ´ | e programovanie ´
2. Graficke pou ´ | | zˇívateľske rozhranie (GUI) ´
3. Webova aplik ´ | | acia ´
3.2.1 Hardverov ´ | e programovanie ´
Prva f ´ aza sa zaober ´ | a prim ´ | arnym filtrovan ´ | ím na urovni mikroprocesora. Pozost ´ | ava z potl ´ | aćania ˇ
sieťovoveho brumu, kol ´ | ísania nulovej línie a inych artefaktov (vi ´ | d. podkapitolu ˇ | 2.5 Signal´
a jeho spracovanie). Na tento ućel boli pou ˇ | zit ˇ e zdrojov ´ | e k´ ody z vo ´
ľne dostupneho internetov ´ | eho ´
repozitara ´

4

, kedže n ˇ | avrh filtrov nespad ´ | a do sf ´ | ery p ´ | osobnosti tejto odbornej pr ˆ | ace. V k ´ | ode ´
su implementovan ´ | e kni ´ | znice filtrov FIR a IIR. Obsahuje taktie ˇ | z matematicky odvoden ˇ | e koefi- ´
cienty, ktore ur ´ | cuj ˇ u charakteristiky filtrov zvl ´ | aśˇť prisposoben ˆ | e k elektrokardiografii. Softv ´ | er bol ´
doplneny o algoritmus, ktor ´ | y popri filtrovan ´ | í sućasne riadi vysokor ˇ | ychlostn ´ | e zaznamen ´ | avanie ´
udajov na pripojen ´ | u pam ´ | a¨ťovu kartu MicroSD. ´
3.2.2 Graficke pou ´ | zˇívateľske rozhranie (GUI) ´
Na zobrazenie zmeranej krivky EKG existuju tri mo ´ | znosti. Jedna z nich je mechanick ˇ | y sp ´ | osob, ˆ
ciˇ ze tepeln ˇ | a tla ´ | c na papier. ˇ | Dal ˇ sie s ˇ | u integrovan ´ | a obrazovka alebo extern ´ | e zariadenie s disple- ´
jom. Najuniverzalnej ´ | sie a najekonomickej ˇ | sie rie ˇ | senie je sign ˇ | al spracova ´ | ť na pocˇítaci. Pri vo ˇ

ľbe
vhodneho prostredia na tvorbu softv ´ | eru sa prihliadalo i na multiplatformovos ´ | ť.
Processing 3 je voľne dostupna grafick ´ | a kni ´ | znica a v ˇ | yvojov ´ | e prostredie (IDE), ktor ´ | e disponuje ´
prostriedkami umozňuj ˇ ucimi vykres ´
ľovanie grafov a priamu komunikaciou s mikrokontrol ´ | erom. ´
Processing funguje na zaklade programovacieho jazyka Java a obsahuje ´ | dal ˇ sie roz ˇ | sˇírene tech- ´
nicke a matematick ´ | | e n ´ astroje. ´
Seriov ´ | a komunik ´ | acia prebieha pomerne vysokou prenosovou r ´ | ychlos ´ | ťou 115200 bps pre
dosíahnutie co najv ˇ | a¨cšieho rozl ˇ | ísenia. Prich ˇ | adzaj ´ | uce ´ | udaje odchyt ´ | ava ´ | sledovac udalost ˇ | í (event
listener), ktory m´ | a za ´ | ulohu ich transformova ´ | ť do rozsahu zobraziteľneho. ´
O samotne vykres ´
ľovanie grafu sa stara nat ´ | ívna funkcia draw(), ktora sa opakovane vykon ´ | ava ´
pocas behu programu. Definuje nov ˇ | e s ´ uradnice krivky grafu a sp ´ | aja ich s posledn ´ | ym zn ´ | amym ´
bodom grafu.
Graficke u ´ zˇívateľske rozhranie zabezpe ´ | cuje kni ˇ | znica ControlP5 zvl ˇ | aśˇť urcen ˇ a pre v ´ | yvojov ´ | é
prostredie Processing. Upravou a roz ´ | sˇírením jej tried boli na mieru vytvorene ovl ´ | adacie prvky. ´
4Repozitar sa nach ´ | adza na adrese https://github.com/tttapa/Filters a vlastn ´ | íkom je Pieter Pas.

21

Funkcie programu zah´rnaj ˇ u v ´ yber vstupn ´ | eho portu, ukladanie sn ´ | ímok grafu a exportovanie
zaznamenanych hodn ´ | ot. V ˆ | yber portu funguje pomocou rozotv ´ | aracej ponuky (dropdown menu), ´
ktora obsahuje v ´ | setky dostupn ˇ | e rozhrania. Po zvolen ´ | í portu, ak bol uspe ´ | sne otvoren ˇ | y, sa za ´ | cne ˇ
vykresľovať graf na obrazovke. Naľavo od tejto listy sa nach ˇ | adza tla ´ | cidlo na zosn ˇ | ímanie obra-
zovky. Snímka sa nasledne ulo ´ | zˇí do predvoleneho adres ´ | ara. Tretia mo ´ | znos ˇ | ť je nahravanie ´
meranych hodn ´ | ot prostredn ˆ | íctvom prepínaca ,,REC”. Po ukon ˇ | cen ˇ í zaznamu - op ´ | atovn ¨ | ym kliknut ´ | ím
na prepínac - sa vygeneruje s ˇ | | ubor CSV. ´

22

## 4 Vysledky a diskusia ´

Komplexna odborn ´ | a pr ´ | aca sa zaober ´ | a z ´ ískavaním, zhromazďovan ˇ | ím a spracuvan ´ | ím somatickych ´
ukazovateľov, presnejsie elektrick ˇ | ych impulzov srdca. Prezentuje funk ´ | cnˇ e rie ´ | senie prejedn ˇ | avanej ´
problematiky a vzťahujucej sa te ´ | orie. V ´ | ystupy projektu s ´ | u v ´ ysledkom nieko ´
ľkomesacnˇ eho v ´ | y-´
skumu, dizajnu, prototypovania a testovania roznych technick ˆ | ych alternat ´ | ív.
Vystupy pr ´ | ace s ´ | u nasledovn ´ | e:´

Kvantitatívne

1. Tvorba a navrh nez ´ | avisl ´ | eho, ´ | ućelov ˇ | eho hardv ´ | eru ´
2. Graficka po ´ | cˇítacov ˇ a aplik ´ | acia ´
3. Interaktívne webove rozhranie ´
4. Podrobna dokument ´ | acia problematiky a pracovn ´ | eho postupu ´

Kvalitatívne

1. Dostupne rie ´ | senie komplexn ˇ | eho probl ´ | emu ´
2. Prospesnˇ e premostenie r ´ | oznych odborov: zdravotn ˆ | íctva, elektroniky a informatiky
3. Aplikacia a presadenie te ´ | orie EKG do praxe ´
4. Oboznamenie verejnosti s mo ´ | | | znos ˇ | ťami EKG
Predmetom prace je sledovanie srdcov ´ | eho rytmu. ´ | Kombinaciou r ´ | oznych postupov a ˆ | uprav ´
vzniká ziadan ˇ | y graf. Prvotne mus ´ | í zosnímany sign ´ | al prejs ´ | ť niekoľkonasobn ´ | ym zosilnen ´ | ím.
Nasledne je preveden ´ | y do digit ´ | alnej podoby na ´ | dal ˇ sie spracovanie. Prij ˇ | íma ho signalov ´ | y pro- ´
cesor, ktory m´ | a na staros ´ | ť odfiltrovať rusivˇ é cinitele. Tento ˇ | ućinok sa dosahuje za pomoci ˇ
cˇíslicovych filtrov a matematick ´ | ych modelov. V ´ | ysledok sa bu ´ | d priamo zapisuje na d ˇ | atov ´ | y nosi ´ | cˇ
alebo sa prenaśa do po ˇ | cˇítaca. V pr ˇ | ípade druhej alternatívy data v re ´ | alnom ´ | case vykres ˇ

ľuje
pocˇítacov ˇ a aplik ´ | acia. Taktie ´ | z ro ˇ | zširuje mo ˇ | znosti pr ˇ | ace so sign ´ | alom v ´ | daka dostupn ˇ | ym pro- ´
gramovym prostriedkom. U ´ | zˇívatelia budu ma ´ | ť prílezitos ˇ | ť data prehliada ´ | ť a zdieľať cez webové
rozhranie.
Vizualna sch ´ | ema pop ´ | ísaneho postupu je uveden ´ | a ni ´ | zšie v podobe blokov ˇ | eho diagramu. ´
Vstupné udaje s ´ | u na ´ | nom zn ˇ | azornen ´ | é sˇípkou v ľavom hornom rohu. Sˇípka smeruje k prvemu ´
ramcu (bloku), ktor ´ | y zastupuje samostatn ´ | y krok v re ´ | ťazi ukonov. Tento sled ´ | ukonov zabezpe ´ | cuje ˇ
premenu udajov na inform ´ | acie a vedie k v ´ | ystupn ´ | ym bodom, ak ´ | ymi s ´ | u napr ´ | íklad pama¨ťova karta ´
a graficke rozhranie po ´ | cˇítacovej alebo webovej aplik ˇ | acie. ´

23

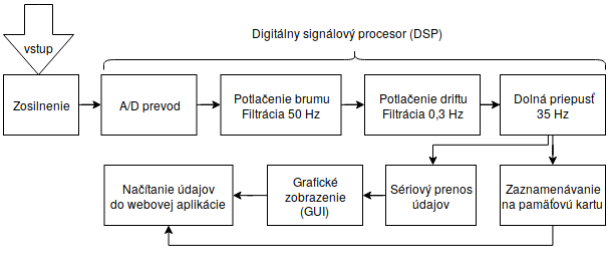
[picture p21: figure]

Obrazok 8: Blokov ´ | a sch ´ | ema spracovania EKG ´
Bezpecnos ˇ | ť Zariadenie nie je urcen ˇ e na masov ´ | e pou ´ | zitie, preto jeho bezpe ˇ | cnos ˇ | ť nie je oficialne ´
zarucen ˇ a. Pri n ´ | avrhu boli zoh ´
ľadnene mo ´ | znˇ e rizik ´ | a pri prev ´ | adzke zariadenia a implementovali ´
sa primerane bezpe ´ | cnostn ˇ | e opatrenia. ´
Najdole ˆ zitej ˇ | sou ochranou je vyl ˇ | ućenie nap ˇ | ajania laborat ´ | ornym zdrojom. Pri nespr ´ | avnom ´
nastavení alebo poruche zdroja by sa nebezpecnˇ y pr ´ | ud mohol dosta ´ | ť do kontaktu s telom vysetro- ˇ
vaneho. Aby sa podobn ´ | emu scen ´ | aru zabr ´ | anilo, obvod nap ´ | ajaj ´ u tri AA ´ | clˇ anky (4,5V). ´
Pri jednosmernom prude m ´ | a najv ´ | a¨cšˇí vyznam elektrolytick ´ | y´ ućinok, preto ˇ | ze v ˇ | a¨cšie elektro- ˇ
chemicke zmeny dr ´ | aźdia pohybov ˇ | e nervy, ´ | cˇím sposobuj ˆ | u k ´ ´rcovit ˇ | e stiahnutie svalov. Pri ve ´

ľkych ´
prudoch sa zastavuje ´ | zivotn ˇ | á cinnos ˇ | ť buniek.
Jednosmerne pr ´ | udy do 3 mA nevyvol ´ | avaj ´ | u oby ´ | cajne ˇ | ziadny pocit. Pri 5-10 mA s ˇ | u sprievodn ´ | é
znaky svrbenie a pocit tepla. Ak prud prech ´ | adza hrudn ´ | íkom, pri prudoch 80-100 mA je d ´ | ychanie ´
takmer nemoznˇ e, komory srdca sa za ´ | cnˇ u k ´ | ´rcovito s ˇ | ťahovať (fibrilacia kom ´ | or) a doch ˆ | adza ´
k zastave krvn ´ | eho obehu. ´
Prípojne miesta tela na EKG: ´
- Prava noha - bod uzemnenia. S ´ | am o sebe nepredstavuje nebezpe ´ | censtvo. M ˇ | a rovnak ´ | y´
efekt ako napríklad pouzitie antistatick ˇ | eho n ´ | aramku. ´
- Hrudny zvod ´ | c. 1 - spojen ˇ | y s vysokoimpedan ´ | cnˇ ym vstupom zosil ´ | nova ˇ | ca a s bat ˇ | eriou cez ´
10 MΩ rezistor (chrani pred nebezpe ´ | cnˇ ym pr ´ | udom). ´
- Hrudny zvod ´ | c. 2 - okrem vysokoimpedan ˇ | cnˇ eho vstupu zosil ´ | nova ˇ | ca je tie ˇ | z spojen ˇ | y´
s vystupom cez 100 k ´ | Ω rezistor. Treba si vsak uvedomi ˇ | ť, ze tento pr ˇ | ud ani pri maxim ´ | alnych ´
hodnotach (4,5V) nepresahuje 0,045mA. ´
Bezpecnos ˇ | ť zariadenia by sa dalej mohlo vylep ˇ | siˇ ť oddelením optoclˇ ankom. V tom pr ´ | ípade
by sa dosiahla upln ´ | a separ ´ | acia vstupn ´ | ych elektr ´ | od od elektrickej ´ | casti. ˇ

24

Ocistenie sign ˇ | alu od ne ´ | ziaducich faktorov ˇ
Vdaka kombin ˇ | acii hardv ´ | erov ´ | ych a softv ´ | erov ´ | ych filtrov sa podarilo dosiahnu ´ | ť vyhovujuci ´
vysledok. Sign ´ | al prech ´ | adza viacstup ´ | nov ˇ ym filtrovan ´ | ím. V rade filtrov vystupuje Butterworth,
linearny filter a dve p ´ | asmov ´ | e priepuste. ´
Dal ˇ sie sp ˇ | osoby zni ˆ | zovania dopadu ru ˇ | sivˇ ych faktorov s ´ | u mechanick ´ | eho druhu. Pri meran ´ | í
mame mo ´ | znos ˇ | ť aplikovať vodivy g´ el, ktor ´ | y zni ´ | zuje odpor medzi poko ˇ | zkou a sn ˇ | ímacími elektrodami. ´
Pokojova poloha v ´
ľahu, d´lzka a tienenie k ˇ | ablov a zdroj nap ´ | ajania taktie ´ | z dok ˇ | aźu ovplyvni ˇ | ť
konecnˇ y sign ´ | al. ´
Spolocnˇ ym efektom vymenovan ´ | ych preven ´ | cnˇ ych prostriedkov je elimin ´ | acia artefaktov r ´ | ozneho ˆ
povodu. Na grafoch ni ˆ | zšie sa zn ˇ | azor ´ | nuje podoba sign ˇ | alu pred procesom filtrovania a po ´ | nom. ˇ


Obrazok 9: Krivka EKG po viacstup ´ | novom filtrovan ˇ | í


Obrazok 10: Artefakt na z ´ | azname EKG ´
Prínosy projektu a moznosti vyu ˇ | zitia ˇ
Projekt svedcˇí o tom, ze aj pomerne zlo ˇ | zit ˇ e oblasti, ako elektrokardiografia, m ´ | oẑu by ˇ | ť rel-
evantne na stredo ´ | skolskej ˇ | urovni. Jednou zo sf ´ | er, kde m ´ | oẑe by ˇ | ť uźito ˇ | cnˇ y je pr ´ | ave vzdel ´ | avanie. ´
Praca sa zaober ´ | a te ´ oriou EKG a jej praktick ´ | ym vyu ´ | zit ˇ ím. Demonstruje z ˇ | akladn ´ | e princ ´ | ípy fun-
govania dole ˆ zit ˇ eho druhu zdravotn ´ | | | íckeho príslusenstva. ˇ
Okrem toho umozňuje laikom sledova ˇ | ť pulz, odhaliť prítomnosť arytmií v pohodlí domaceho ´
prostredia. Tym otv ´ | ara nov ´ | e mo ´ | znosti na nelek ˇ | arske pou ´ | zitie EKG. V pripade potreby sa ˇ
vysledky daj ´ | u jednoducho zdie ´

ľať s odborníkom cez internet. Obmedzenia riesenia ˇ
Riesenie m ˇ | a samozrejme aj svoje nev ´ | yhody. Jedn ´ | ym z hlavn ´ | ych nev ´ | yhod je limitovanie ´
poctu zvodov na jeden, ˇ | co v ˇ | yrazne obmedzuje mno ´ | zstvo inform ˇ | aci ´ í potrebnych na stanovanie ´
presnej diagnozy. ´ | Dalej, ke ˇ | dže je hardv ˇ | er minimalistick ´ | y, rozl ´ | ísenie a kvalita merania ne- ˇ
dosahuje urove ´ | n komer ˇ | cnˇ ych lek ´ | arskych pr ´ | ístrojov.

25

Diskusia
V akademickej sfere existuje nem ´ | alo ´ | studi ˇ | í a odbornych pr ´ | ac, ktor ´ | e sa venuj ´ | u pr ´ | ave t ´ | eme ´
elektrokardiografie. Toto medicínske odvetvie preslo od jeho zalo ˇ | zenia pred vy ˇ | se sto rokmi ˇ
mnohymi v ´ | yrazn ´ | ymi zmenami a vylep ´ | seniami v ˇ | daka rozsiahlemu v ˇ | yskumu. ´
Tento projekt je praktickeho charakteru, nesna ´ | zˇí sa prekonať sućasn ˇ | e technol ´ | ogie a poznatky, ´
ale prezentuje ich principialnu podstatu dostupn ´ | ymi prostriedkami. Zadan ´ | e ciele boli splnen ´ | e:´
(1) spracovanie vztahuj ˇ | ucej sa te ´ | orie ´ | , (2) navrh a kon ´ | strukcia pr ˇ | ístroja EKG, (3) programovanie
mikrokontrolera ´ , (4) digitalne spracovanie ´ | udajov ´ | .
Opísane rie ´ | senie merania EKG ˇ | uvodn ´ | ym po ´ | ziadavkam vyhovelo. V ˇ | setky n ˇ | alezy s ´ | u zrepro- ´
dukovateľne na z ´ | aklade dokument ´ | acie pracovn ´ | eho postupu. Skuto ´ | cnˇ u v ´ yzvu t ´ | ykaj ´ | ucu sa danej ´
problematiky vsak predstavuje navrhnutie pr ˇ | ístroja spoľahliveho za ka ´ | zdˇ ych okolnost ´ | í. Splne-
nie takehoto n ´ | aroku si vy ´ | zaduje robustn ˇ | e medic ´ | ínske riesenie a na ˇ | dalej zost ˇ | ava mimo dosahu ´
pouzˇívateľskych apar ´ | atov - ´ | ci u ˇ | z smart hodiniek alebo dosiek Arduino. ˇ

26

5 Zavery pr ´ | ace ´
Prílezitos ˇ | ť na ucenie sa pon ˇ | uka ka ´ | zdou ˇ
ľudskou interakciou. Nove poznatky sa preveruj ´ | u a ´ dalej ˇ
utvrdzuju presaden ´ | ím do praxe. Je vseobecne zn ˇ | ame, ´ | ze sa ˇ | clovek najefekt ˇ | ívnejsie u ˇ | cˇí skuśan ˇ ím,
z vlastnych ´ | uspechov a ch ´ | yb. Pr ´ | ave tieto vzostupy a p ´ | ady sprev ´ | adzaj ´ | uce na ´ | se pokusy n ˇ | as ve ´ | cne ˇ
zen ˇ u dopredu po ceste celo ´ | zivotn ˇ | eho vzdel ´ | avania. ´
Tato odborn ´ | a pr ´ | aca mo ´ | zno nie je jedin ˇ | a svojho druhu, ale je v ´ | ynimo ´ | cnˇ a svojou mnoho- ´
strannosťou. Zjednocuje diametralne odli ´ | snˇ e oblasti - zdravotn ´ | íctvo a informatiku - a svedcˇí
o prospechu ich pospolitosti. Cerp ˇ | a z vedomostn ´ | ych rezerv obidvoch odborov a opakovane ´
poukazuje na mnozstvo kri ˇ | zovatiek, ktor ˇ | e ich sp ´ | ajaj ´ u. Pr ´ | ave tieto spolo ´ | cnˇ e body ustanovuj ´ | ú
predpoklady interdisciplinarneho dial ´ | ogu. ´
Kľućovou motiv ˇ | aciou k v ´ | yberu t ´ | emy bola i potreba upriami ´ | ť pozornosť na dole ˆ zit ˇ u rolu, ´
ktoru hr ´ | a prevencia v zdrav ´ | í jedinca. Napriek tomu, ze mnoh ˇ | ym chorob ´ | am sa pred ´ | ísť neda,´
spravna ´ | zivotospr ˇ | ava m ´ | á dalekosiahly dopad na imunitu a obranyschopnos ˇ | ť tela. Nepripuśˇťajme
si apatickosť, neoddavajme sa ´ | skodliv ˇ | ym n ´ | avykom, ve ´ | d zodpovednos ˇ | ť za zivotn ˇ | y´ stˇ yl ak ´ | y vedie- ´
me nesieme sami.
Elektrokardiografia si v medicíne za poslednych sto rokov jej existencie z ´ | ískala nespochyb-
niteľny re ´ | spekt. V zdravotn ˇ | íckych zariadeniach, ambulanciach, nemocniciach i v ter ´ | ene zachra- ´
nuje ˇ | zivoty ka ˇ | zdˇ y de ´ | n. D ˇ | ufajme, ´ | ze snahy o odkrytie niektor ˇ | ych nu ´ | ans za mechanizmom jej ´
fungovania a o nalez prieniku medzi odbornos ´ | ťou a praktickosťou boli v konecnom d ˇ | osledku ˆ
uspe ´ | snˇ e.´
Odkaz tejto prace dokonale vystihuj ´ | u slov ´ | a Ren ´ | eho Descarta: ,,Pozn ´ | avanie pravdy je zdravie ´
ľudskeho ducha.“ ´

### Resumé

The objective of this project was to create a working single lead EKG. The work process was divided into several stages to provide clarity and a productive development framework. Firstly, the hardware had to be layed out, manufactured and constructed. Then followed the phase of software design, development and deployment on different application layers. The finished product encompasses both physical and intellectual components.
The device measures biopotentials using body-surface electrodes. After amplification the signal is processed and filtered by a programmable microchip. Next, the filtered data gets trans-ferred into the computer, where a program plots out the resulting graph. The input stream can be saved for later use either as a visual snapshot or as a data file.
A lot can be learned from such a comprehensive, theoretically and practically challanging undertaking. Let the subject of this project be a testimony to the importance of interdisciplinary research and exchange of knowledge.

27

6 Zoznam pouzitej literat ˇ | ury ´
[1] GEMINI, spol. s.r.o. 1991. Ludsk ˇ | e telo - Komplexn ´ | y sprievodca po ´

ľudskom tele a jeho
funkciach. Bratislava. ISBN 80-85265-12-5. ´
[2] IAIZZO, Paul A. 2005. Handbook of Cardiac Anatomy, Physiology, and Devices. New Jersey. Human Press, Inc. ISBN 1-59259-835-8.
[3] HANÁ CEK, J ˇ | an, PLEVKOV ´ | A, Jana. 2009. Elektrokardiografia - Z ´ | akladn ´ | e mechanizmy ´
poruch elektrickej funkcie srdca a ich manifest ´ | acia na Ekg krivke. Martin. ´ | Ustav patolog- ´
ickej fyziologie JLF UK. ´
[4] MALMIVUO, Jaakko, PLONSEY, Robert. 1995. Bioelectromagnetism - Principles and Applications of Bioelectric and Biomagnetic Fields. Oxford. Oxford University Press.
[5] BORIKOV ´ | A, Ivana. 2016. Funk ´ | cnˇ e vy ´ | setrenie respira ˇ | cnˇ eho, kardiovaskul ´ | arneho a mo ´ | cov ˇ eho ´
systemu. Port ´ | al Jesseniovej lek ´ | arskej fakulty Univerzity Komensk ´ | eho. ISSN 1337-7396. ´
[6] MISČˇ ÍK, Peter. 2011. Zpracovan´ í elektrokardiogramu. Vysoke u ´ cen ˇ í technicke v Brn ´ | e.ˇ
[7] TUKA, Marian. 2015. Potla ´ | cen ˇ í aditivního sumu. Vysok ˇ | e u ´ cen ˇ í technicke v Brn ´ | e.ˇ
[8] www.kardiolog.sk/o-srdci/
[9] www.techmed.sk/akcny-potencial/
[10] www.wikiskripta.eu/w/Rusen ˇ í biosignal´ u˚ a artefakty
[11] www.swharden.com/wp/2016-08-08-diy-ecg-with-1-op-amp/
[12] www.arduino.cc/en/Tutorial/ArduinoToBreadboard
[13] www.microchip.com/wwwproducts/en/ATmega328p
[14] techfun.sk/produkt/ft232rl-programator-s-mini-usb-5v-3-3v/
[15] techfun.sk/produkt/slot-pre-micro-sd-kartu/
[16] github.com/tttapa/Filters

28

## 7 Prílohy

### Príloha A (obsah CD)

- Schema zapojenia a n ´ | avrh plo ´ | snˇ eho spoja vyexportovan ´ | e z Eaglu ´
- Program nahraty na mikroprocesor a pou ´ | zit ˇ e kni ´ | znice ˇ
- Zdrojovy k ´ od po ´ | cˇítacovej aplik ˇ | acie a spustite ´

ľny s ´ ubor ´

- Zdrojovy k ´ od webovej str ´ | anky ´

### Príloha B

- Fotodokumentacia projektu ´

29
