andraszemes/one-lead-ecg/software/web/images/headshot.jpg

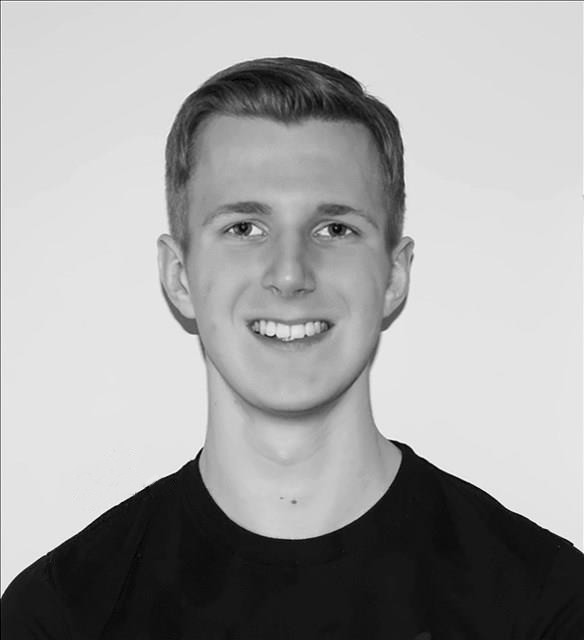
software/web/images/headshot.jpg
