andraszemes/one-lead-ecg/docs/img/assembly-3.png

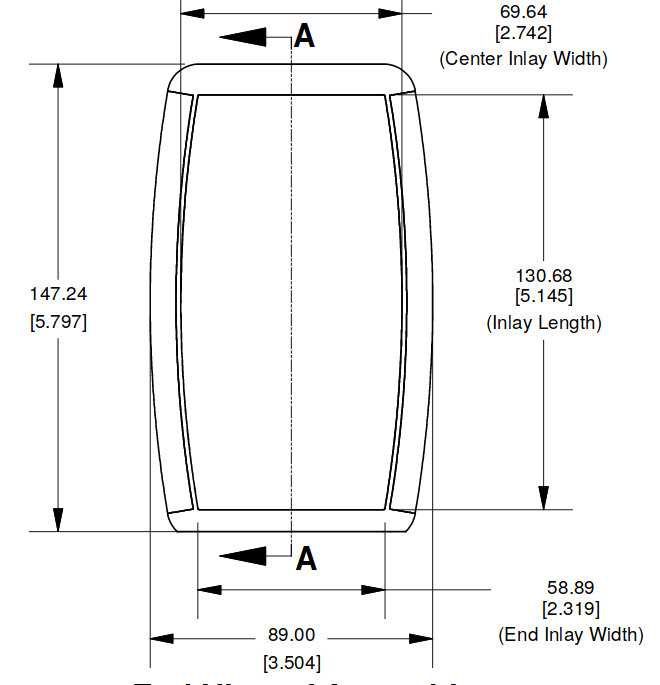
docs/img/assembly-3.png
