andraszemes/one-lead-ecg/hardware/ecg-schematic.brd

## EAGLE design hardware/ecg-schematic.brd (2019-02-04)

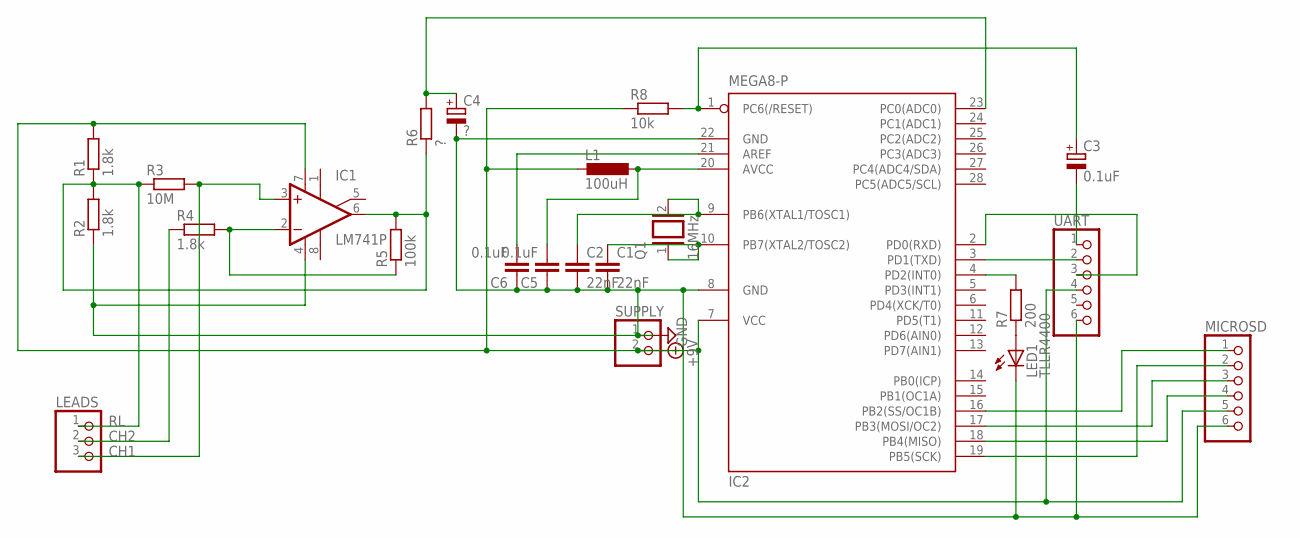
[picture p24: schematic ecg-schematic.sch]

Parts:
C1, C2: 22nF; C025-025X050
C3: 0.1uF; B45181A
C4: ?; ETR1
C5, C6: 0.1uF; C025-025X050
IC1: LM741P; DIL08
IC2: MEGA8-P; DIL28-3
L1: 100uH; 0204/5
LEADS: PINHD-1X3; 1X03
LED1: TLLR4400; LED3MM
MICROSD: PINHD-1X6; 1X06
Q1: 16MHz; QS
R1, R2, R4: 1.8k; 0204/7
R3: 10M; 0204/7
R5: 100k; 0204/7
R6: ?; 0204/7
R7: 200; 0204/7
R8: 10k; 0204/7
SUPPLY: PINHD-1X2; 1X02
UART: PINHD-1X6; 1X06

Connections:
+9V: IC1.7 (V+), IC2.7 (VCC), L1.2, MICROSD.5, R1.2, R8.1, SUPPLY.2, UART.4
CH1: IC1.3 (+IN), LEADS.3, R3.2
CH2: LEADS.2, R4.1
GND: C1.2, C2.2, C4.-, C5.1, C6.1, IC1.4 (V-), IC2.8 (GND), IC2.22 (GND), LED1.K (C), MICROSD.6, R2.1, SUPPLY.1, UART.6
unnamed: C2.1, IC2.9 (PB6(XTAL1/TOSC1)), Q1.2
unnamed: C1.1, IC2.10 (PB7(XTAL2/TOSC2)), Q1.1
unnamed: IC1.2 (-IN), R4.2, R5.1
unnamed: C3.-, UART.1
unnamed: C3.+, IC2.1 (PC6(/RESET)), R8.2
unnamed: IC2.3 (PD1(TXD)), UART.2
unnamed: IC2.2 (PD0(RXD)), UART.3
unnamed: C4.+, IC2.23 (PC0(ADC0)), R6.2
unnamed: IC2.16 (PB2(SS/OC1B)), MICROSD.1
unnamed: IC2.19 (PB5(SCK)), MICROSD.2
unnamed: IC2.17 (PB3(MOSI/OC2)), MICROSD.3
unnamed: IC2.18 (PB4(MISO)), MICROSD.4
unnamed: LED1.A, R7.1
unnamed: IC2.4 (PD2(INT0)), R7.2
unnamed: C5.2, IC2.20 (AVCC), L1.1
unnamed: C6.2, IC2.21 (AREF)
RL: IC1.6 (OUT), LEADS.1, R1.1, R2.2, R3.1, R5.2, R6.1

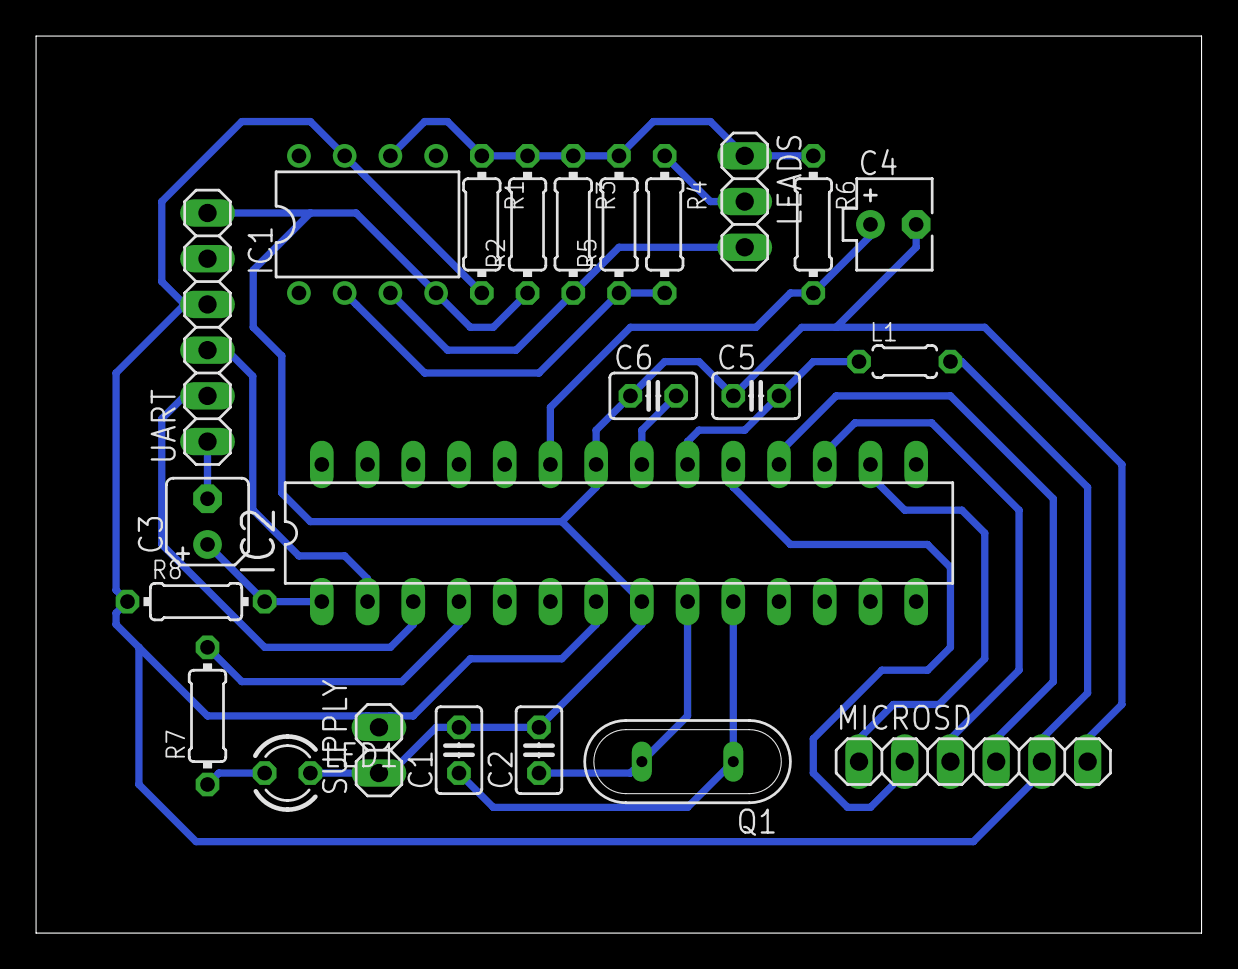
[picture p25: board ecg-schematic.brd from above]

Board: 2 copper layers, 64.8 x 49.8 mm, 23 parts (0 on the bottom side), 21 nets.
