andraszemes/one-lead-ecg/(commit log)

2019-02-04 Add software, hardware design components.
    [ecg-schematic.brd, ecg-schematic.sch, example.csv]
2019-02-14 Add software description. Fix title page. Add filters quotes. Add attachments.
2019-02-25 Add results, conclusions, resume.
    [ekg-artefacts.csv, ekg-log.csv]
2019-02-28 Docs corrections. Add attachments.
2019-03-02 Update web page. Add server upload. Add link share. Add contact and about sections.
    [05c90f78ee05e8dc4e3a6f0a435fc304.csv, 097875707aa14cb4dcbc658533a8fc5c.csv, 0f413cf5dcd407ebc07885a33f20b21b.csv, 15defbfa36496b6d3d0740c229677969.csv, 1aa32573850186e1387aaf71d3846971.csv, 2e40d373fa51138069d07dced486c2d6.csv, 3cd1b27abf5d3ae4ec0daf08ecf288be.csv, 4cb86da14348b4f4820ba7fec8e6d4c1.csv]
2019-03-02 Readme corrections. Arduino sketch update.
    [sketch_ecg_filter.ino]
2019-03-16 Documentation final corrections.
    [05c90f78ee05e8dc4e3a6f0a435fc304.csv, 097875707aa14cb4dcbc658533a8fc5c.csv, 0f413cf5dcd407ebc07885a33f20b21b.csv, 15defbfa36496b6d3d0740c229677969.csv, 1aa32573850186e1387aaf71d3846971.csv, 2e40d373fa51138069d07dced486c2d6.csv, 3cd1b27abf5d3ae4ec0daf08ecf288be.csv, 4cb86da14348b4f4820ba7fec8e6d4c1.csv]
